danielonofri/AguaSimbolar/Doc/esp8266.jpg

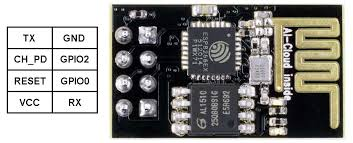
Doc/esp8266.jpg
