danielonofri/AguaSimbolar/Doc/Conversor3.3 a 5v.webp

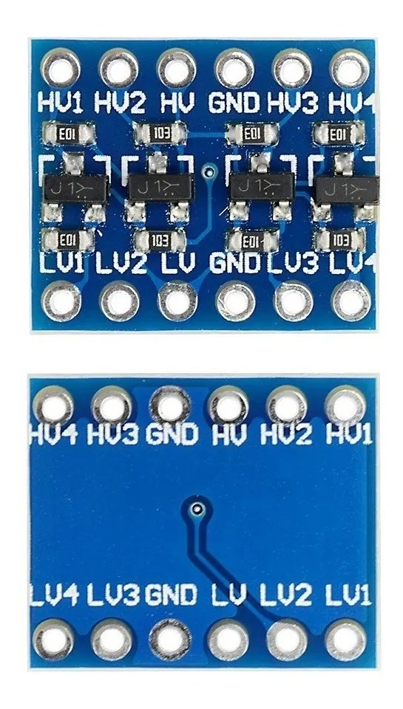
Doc/Conversor3.3 a 5v.webp
