danielonofri/AguaSimbolar/Conexiones.xlsx

Transmisor
Componente | Pin del Dispositivo | Pin Arduino Uno | Definición en Código | Función / Notas
LoRa XL1278-SMT | NSS (CS) | 10 | #define CSN_PIN 10 | Selección de chip SPI
 | NRESET | 9 | #define CE_PIN 9 | Reset del módulo
 | SCK | 13 | (Hardware SPI) | Reloj de datos
 | MOSI | 11 | (Hardware SPI) | Salida de datos
 | MISO | 12 | (Hardware SPI) | Entrada de datos
 | DIO0 | 2 | (Libre) | Disponible (según tu indicación)
 | VCC | 3.3V | (Hardware) | Alimentación obligatoria
 | GND | GND | (Hardware) | Tierra
Sensor JSN-SR04T | Trigger | 4 | #define SU_TRIGGER 4 | Disparo del pulso
 | Echo | 5 | #define SU_ECHO 5 | Recepción del eco
Interruptores | SW 1 | (Libre) | (Sin conexión) | Está libre
 | SW 2 | 6 | #define SW2 6 | Switch 2 (INPUT_PULLUP)
 | SW 3 | 7 | #define SW3 7 | Switch 3 (INPUT_PULLUP)
 | SW 4 | 8 | #define SW4 8 | Switch 4 (INPUT_PULLUP)
Receptor
Componente | Pin del Dispositivo | Pin NodeMCU | Definición en Código | Función / Notas
LCD I2C | SDA | D2 (GPIO4) | Comunicación de datos
 | SCL | D1 (GPIO5) | Comunicación de reloj
Botón Config | Pin A | D4 (GPIO2) | #define PIN_RESET D4
Botón Pantalla | Pin A | D3 (GPIO0) | #define PIN_TOGGLE_LCD D3
LoRa XL1278-SMT | NSS (CS) | D8 (GPIO15) | Selección SPI estándar
 | SCK | D5 (GPIO14) | SPI Clock
 | MOSI | D7 (GPIO13) | SPI MOSI
 | MISO | D6 (GPIO12) | SPI MISO
 | NRESET | D0 (GPIO16) | Reset del módulo
