danielonofri/AguaSimbolar/(commit log)

2026-01-30 Guardando cambios locales antes de rebase
2026-02-17 Receptor cuasi completo
    [Conexiones.xlsx]
2026-02-19 2026/02/19 Actualizado sin servidores antes de half duplex
